Grsliy/mcu-flow-continuity-bernoulli/desain/perakitan-01-dalam-tangki.md

# Perakitan 1 — Dalam Tangki (Langkah 1–8)

Jalur dari pompa sampai tank connector di dinding tangki. Semua di dalam tangki, **PVC 1/2"**. Sketsa tampak atas: `sketsa-atas-tangki.html`.

```
                                   dinding tangki
                     ⑥ siku    ⑦ pipa   │
                       ┌═══════════[SDL]═⑧═ tank connector ──► S1 (langkah 9)
                       │                │
                       │ ⑤ pipa naik    │
                       │                │
 [① POMPA]─[② KATUP]─③─④ siku           │
 ═══════════ dasar tangki ══════════════╧
```

## Langkah

| No | Dari → ke | Barang | Ukuran | Panjang potong | Cara pasang |
|---|---|---|---|---|---|
| 1 | Pompa → katup | **Katup searah kuningan (swing)**, disekrup langsung ke outlet pompa | 1/2" | ± 6 cm (badan katup) | Seal tape 5–6 lilitan, kencangkan dengan tangan. Panah menjauhi pompa, tutup segi enam menghadap atas |
| 2 | Katup → SDL | **SDL** (sok drat luar): ulir ke katup, sisi lem ke pipa | 1/2" | — | Seal tape di ulir SDL, sekrup ke katup |
| 3 | SDL → pipa | **Pipa PVC mendatar** di dasar tangki | 1/2" | ± 6 cm | Lem PVC |
| 4 | Pipa → siku | **Siku 90°**, lubang satunya menghadap **atas** | 1/2" | — | Lem PVC |
| 5 | Siku → pipa | **Pipa PVC tegak** | 1/2" | ± 9 cm | Lem PVC |
| 6 | Pipa → siku | **Siku 90°**, lubang satunya menghadap **dinding** | 1/2" | — | Lem PVC |
| 7 | Siku → pipa | **Pipa PVC mendatar** ke dinding, setinggi ± 12 cm dari dasar | 1/2" | ± 6–10 cm, ukur di tempat | Lem PVC |
| 8 | Pipa → tank connector | **SDL** dilem ke ujung pipa, lalu disekrup ke **tank connector** (drat dalam di kedua sisi) yang menembus dinding | 1/2" | — | Seal karet di sisi dalam tangki, mur dikencangkan dari luar dengan tangan. Seal tape di ulir SDL |

## Belanja

- 1 katup searah kuningan swing 1/2" (bukan tipe pegas)
- 2 SDL 1/2"
- 2 siku 90° 1/2"
- 1 tank connector 1/2", drat dalam di kedua sisi (dengan seal karet dan mur)
- ± 30 cm pipa PVC 1/2"
- Seal tape, lem PVC
- Hole saw sesuai diameter ulir tank connector (± 21–22 mm)

## Catatan

- **Rangkai tanpa lem dulu.** Taruh pompa di dasar tangki, pasang semua bagian, lalu sesuaikan panjang pipa langkah 5 dan 7 sampai ujungnya pas dengan lubang dinding. Baru setelah itu dilem.
- Kalau outlet pompa ternyata **drat dalam**, tambahkan SDL 1/2" di antara pompa dan katup.
- Pipa langkah 3 lewat **di bawah sekat** (sekat tidak sampai dasar, ada celah ± 6 cm).
- Katup searah menahan air di pipa saat pompa mati, sehingga semua kolom manometer tetap terisi (uji nol).
- **Tank connector:** tengah lubang ± 12 cm dari dasar tangki, sejajar pipa langkah 7. Bor pelan dengan hole saw, haluskan tepinya. Seal karet selalu di sisi yang basah (dalam).
- **Urutan kerja:** pasang tank connector dulu → uji bocor (isi air sampai di atas lubang, diamkan beberapa jam) → baru sambungkan rangkaian pipa langkah 1–7.
- Berikutnya — langkah 9: sisi luar tank connector → sensor S1 (YF-S201) langsung disekrup.
