Grsliy/mcu-flow-continuity-bernoulli/catatan/draf-kesepakatan.md

# Kesepakatan Pembuatan Alat Praktikum Fluida Dinamis

*Draf — bagian dalam [kurung siku] diisi sebelum dikirim.*

**Pihak pertama (pembuat):** Guntur Sulistyo
**Pihak kedua (pemesan):** [nama, NIM, program studi]
**Tanggal:** [tanggal]

## 1. Lingkup pekerjaan

Pihak pertama membuat alat praktikum debit, kontinuitas, dan Bernoulli berbasis mikrokontroler, **paket [inti / lengkap]**:

- Paket inti: venturi mendatar + segmen naik, sensor flow, panel manometer, kenop target debit, layar.
- Paket lengkap: paket inti + penyempitan di ketinggian atas dan sensor flow kedua.

**Diserahkan:** alat yang berfungsi, firmware beserta kode sumber, laporan kalibrasi, SOP pemakaian, dan diagram rangkaian.

**Tidak termasuk:** pengambilan data penelitian, analisis data, penulisan skripsi, LKPD, dan instrumen penelitian. Bagian-bagian itu dikerjakan pihak kedua.

## 2. Kriteria alat dinyatakan selesai

1. Debit dapat diatur pada [4–6] L/min dan stabil.
2. Bacaan sensor flow sesuai pengukuran gelas ukur dalam ± [5]%.
3. Selisih kolom venturi sesuai prediksi teori dalam ± [10]% pada 3 debit.
4. Uji nol: saat pompa mati, semua kolom manometer sama tinggi.
5. Tidak ada kebocoran setelah 24 jam terisi air.

## 3. Biaya

| Pos | Jumlah |
|---|---|
| Komponen (sesuai RAB terlampir, dibayar sesuai nota) | ± Rp[...] |
| Jasa | Rp[...] |
| **Total perkiraan** | **Rp[...]** |

Perubahan lingkup setelah kesepakatan ini disepakati tertulis dan dapat menambah biaya.

## 4. Termin

1. Sebelum belanja: dana komponen tahap uji bangku + DP jasa [50]%.
2. Setelah uji bangku lulus: dana komponen sisa.
3. Saat serah terima dan kriteria nomor 2 terpenuhi: pelunasan jasa.

## 5. Jadwal

| Tahap | Target selesai |
|---|---|
| Uji bangku | [tanggal] |
| Perakitan | [tanggal] |
| Kalibrasi & serah terima | [tanggal] |

## 6. Garansi

Perbaikan tanpa biaya jasa selama [1 bulan] setelah serah terima untuk kerusakan akibat perakitan. Komponen yang rusak karena pemakaian diganti dengan biaya pihak kedua.

## 7. Lain-lain

- Pihak kedua bebas memakai alat dan data yang dihasilkan untuk skripsi dan publikasi.
- [Opsional] Pihak pertama boleh membuat ulang desain alat ini untuk pihak lain.

| Pihak pertama | Pihak kedua |
|---|---|
| <br><br>Guntur Sulistyo | <br><br>[nama] |

*Lampiran: RAB (`anggaran/RAB-alat-praktikum-rev08.xlsx`).*
