Grsliy/mcu-flow-continuity-bernoulli/desain/perhitungan/01-pipa-dan-debit.md

# 1 — Pipa & Rentang Debit

Rev. 08. Hitungan ideal (tanpa rugi), g = 9,81 m/s².

| Bagian | Diameter dalam | Luas | Rasio |
|---|---|---|---|
| Pipa besar (S1, zona A, B) | 19 mm | 2,84 cm² | 1 |
| Leher venturi | 10 mm | 0,79 cm² | 3,61 |
| Zona C (opsional) | 13 mm | 1,33 cm² | 2,14 |

⚠️ Diameter mengasumsikan tabung akrilik tebal 3 mm. Ukur diameter riil, lalu hitung ulang.

v = Q/A · Δh = (v₂² − v₁²) / 2g

| Debit | v pipa besar | v leher | v zona C | Δh 1↔2 | Δh 5↔6 | Re |
|---|---|---|---|---|---|---|
| 2 L/min | 0,12 m/s | 0,42 m/s | 0,25 m/s | 8 mm | 3 mm | 2.200 |
| 3 L/min | 0,18 m/s | 0,64 m/s | 0,38 m/s | 19 mm | 6 mm | 3.300 |
| 4 L/min | 0,24 m/s | 0,85 m/s | 0,50 m/s | 34 mm | 10 mm | 4.500 |
| 5 L/min | 0,29 m/s | 1,06 m/s | 0,63 m/s | 53 mm | 16 mm | 5.600 |
| 6 L/min | 0,35 m/s | 1,27 m/s | 0,75 m/s | 76 mm | 23 mm | 6.700 |

**Batas**
- Atas 6 L/min: rentang S2 (YF-S401).
- Bawah: di bawah 4 L/min aliran masih transisi (Re < 4.000); di bawah 3 L/min selisih kolom terlalu kecil untuk dibaca.
- Zona C: selisih hanya 6–10 mm di 3–4 L/min.
- S1 bekerja di ujung bawah rentangnya → wajib kalibrasi.

**Kesimpulan:** debit kerja 4–6 L/min, titik data 4,0 / 4,5 / 5,0 / 5,5 / 6,0 L/min. Zona A = data utama.
