Grsliy/mcu-flow-continuity-bernoulli/arsip/README.md

# Arsip

Materi desain yang **sudah tidak berlaku**, disimpan sebagai jejak keputusan. Jangan dipakai sebagai acuan kerja — acuan aktif ada di `catatan/konteks-dan-spesifikasi.md` dan `desain/`.

| File | Isi | Kenapa diarsipkan |
|---|---|---|
| `draft-desain-awal.md` | Draft desain paling awal | Digantikan catatan spesifikasi |
| `gravity-fed/sketsa-sistem.html` | Diagram blok + tampak samping awal | Arsitektur gravity-fed dibatalkan di Rev. 07 |
| `gravity-fed/peta-eksperimen.html` | Peta "apa dibuktikan di mana" | Masih memakai tangki sumber & mode Isi/Tahan/Mati |
| `gravity-fed/perhitungan-dimensi-rev06.html` | Hitungan dimensi Rev. 06 | Dasar hitungannya tinggi tangki, bukan pompa |
| `gravity-fed/estimasi-budget-rev06.html` | Estimasi budget Rev. 06 (Rp3,0–5,4 jt, opsi A–H) | Komponen berubah (rak & tangki kedua hilang, pompa diganti DC) |

File HTML bisa dibuka langsung di browser.
