Grsliy/mcu-flow-continuity-bernoulli/anggaran/RAB-alat-praktikum-rev08.xlsx

Sheet: RAB
RENCANA ANGGARAN BIAYA — Alat Praktikum Fluida Dinamis (Debit, Kontinuitas, Bernoulli)
Desain: Rev. 08 — satu tangki, pompa langsung, leher angsa, tanpa servo. Paket inti = zona A + B.
Harga perkiraan = kisaran marketplace Indonesia, belum diverifikasi. Kolom kuning diisi setelah riset; total, subtotal, dan ringkasan terhitung otomatis. Total Dipakai memakai harga online bila sudah diisi.
No | Nama Barang | Spesifikasi | Fungsi | Paket | Satuan | Jumlah | Harga Perkiraan (Rp/satuan) | Total Perkiraan (Rp) | Harga Online Shop (Rp/satuan) | Total Online (Rp) | Total Dipakai (Rp) | Selisih (Online − Perkiraan) | Toko / Link | Status | Catatan
A. ELEKTRONIK
1 | ESP32-C3 Super Mini | RISC-V 160 MHz, WiFi/BLE, USB-C, logika 3,3 V | Otak alat: baca S1, kontrol PI pompa, layar, tombol, log data | Inti | pcs | 2 | Rp 40000 |  | Rp 35000 |  |  |  |  | Dipesan | Baru dibeli 1, cadangan belum. Pin tidak tahan 5 V; jangan pakai GPIO 2/8/9 untuk kendali pompa
2 | LCD 20×4 + modul I2C | 20×4 karakter, backlight | Tampil debit, kecepatan, prediksi, pesan error | Inti | pcs | 1 | Rp 75000 |  | Rp 150000 |  |  |  |  | Belum
3 | Sensor flow YF-S201 (S1) | Ulir G1/2", 1–30 L/min, hall-effect | Debit utama | Inti | pcs | 1 | Rp 35000 |  | Rp 29189 |  |  |  |  | Diterima | Wajib dikalibrasi volumetrik
4 | Sensor flow YF-S201 (cadangan) | Sama dengan S1 | Suku cadang bila S1 rusak saat pengambilan data | Inti | pcs | 1 | Rp 35000 |  |  |  |  |  |  | Belum | Bisa dicoret kalau budget ketat
5 | Pompa celup DC 12 V | Brushless 12 V, 22 W, 800 L/jam, drat in/out 1/2" | Mendorong aliran | Inti | pcs | 1 | Rp 120000 |  | Rp 97038 |  |  |  | https://shopee.co.id/MAXPUMP-Pompa-Celup-Air-Bersih-DC-12V-24V-Submersible-Pump-Pompa-Kolam-Ikan-Brushless-5m-Aquarium-Hidroponik-i.17799491.12107841427 | Dipesan | Cek: celup atau inline. Uji ember: tegangan minimum & 4–6 L/min stabil
6 | MOSFET gate 3,3 V | AO3400 / IRLML6244 (atau modul + transistor pendorong), ≥ 3 A | Saklar PWM pompa / kendali buck | Inti | pcs | 2 | Rp 7500 |  |  |  |  |  |  | Belum | Pull-down 10 kΩ di gate → pompa mati saat reset/upload
7 | Modul buck DC-DC 5 A (pompa) | XL4015 / setara, tegangan keluaran bisa diatur | Atur kecepatan pompa lewat tegangan (pompa brushless tanpa kabel PWM) | Inti | pcs | 1 | Rp 30000 |  |  |  |  |  |  | Belum | Cara kendali dari MCU ditentukan saat uji bangku
8 | Level shifter 4 kanal | BSS138, 3,3 V ↔ 5 V | Sinyal YF-S201 & I2C LCD ke ESP32-C3 | Inti | pcs | 1 | Rp 8000 |  |  |  |  |  |  | Belum
9 | Modul step-down 12 V → 5 V | LM2596 / Mini-360 | Catu daya MCU & LCD | Inti | pcs | 1 | Rp 12000 |  | Rp 0 |  |  |  |  | Belum
10 | Adaptor 12 V 5 A | Switching, casing tertutup | Sumber daya utama | Inti | pcs | 1 | Rp 70000 |  | Rp 0 |  |  |  |  | Belum | Letakkan jauh dari air
11 | Sekring + holder inline | 3–5 A | Proteksi hubung singkat | Inti | set | 1 | Rp 8000 |  |  |  |  |  |  | Belum
12 | Saklar daya (rocker) | 6 A | ON/OFF alat | Inti | pcs | 1 | Rp 5000 |  |  |  |  |  |  | Belum
13 | Jack DC panel female | 5,5 × 2,1 mm | Input adaptor | Inti | pcs | 1 | Rp 5000 |  |  |  |  |  |  | Belum
14 | Potensiometer 10 kΩ + knob | Linear, dudukan panel | Kenop target debit | Inti | pcs | 1 | Rp 10000 |  |  |  |  |  |  | Belum
15 | Tombol tekan panel | 12 mm, momentary | Tombol CEK + Start/Stop | Inti | pcs | 2 | Rp 5000 |  |  |  |  |  |  | Belum
16 | Buzzer aktif 5 V |  | Sonifikasi debit & alarm | Inti | pcs | 1 | Rp 5000 |  |  |  |  |  |  | Belum
17 | Komponen pasif | Resistor 10 kΩ & 4,7 kΩ, kapasitor filter, dioda flyback 1N5819 | Pull-down gate, pull-up & filter sensor, proteksi pompa | Inti | paket | 1 | Rp 15000 |  | Rp 0 |  |  |  |  | Belum
18 | PCB lubang + header + terminal sekrup | ± 7 × 9 cm | Papan rangkaian | Inti | set | 1 | Rp 20000 |  |  |  |  |  |  | Belum
19 | Kabel & heatshrink | Kabel serabut, jumper, kabel sensor berpelindung ± 5 m | Pengkabelan; jalur sensor dipisah dari kabel pompa | Inti | paket | 1 | Rp 35000 |  |  |  |  |  |  | Belum | Kabel berpelindung mengurangi pulsa palsu dari derau motor
20 | Kotak elektronik tahan cipratan | Junction box IP65 ± 15 × 10 × 7 cm | Elektronik di atas garis air | Inti | pcs | 1 | Rp 45000 |  |  |  |  |  |  | Belum
21 | Sensor flow YF-S401 (S2) | 0,3–6 L/min | Sensor kedua di zona C | Lengkap | pcs | 1 | Rp 45000 |  | Rp 42211 |  |  |  |  | Diterima | Uji rugi tekanan dulu: harus ≤ ± 90 mm di 6 L/min
22 | Stop kontak / adaptor ber-RCD | Portable RCD 30 mA | Keselamatan listrik dekat air | Opsional | pcs | 1 | Rp 200000 |  |  |  |  |  |  | Belum | Tidak perlu jika stop kontak lab sudah ber-RCD
23 | Sensor tekanan analog 0–10 kPa | MPX5010DP / XGZP6847 | Demo hidrostatis tangki | Opsional | pcs | 1 | Rp 120000 |  |  |  |  |  |  | Belum | Hanya jika hidrostatis masuk materi skripsi
24 | Sensor ultrasonik HC-SR04 |  | Tinggi air tangki (demo hidrostatis) | Opsional | pcs | 1 | Rp 15000 |  |  |  |  |  |  | Belum | Pasangan sensor tekanan di atas
 | Subtotal Elektronik — paket inti
B. MEKANIS — HIDROLIK (pipa, aliran, manometer)
25 | Tangki akrilik custom + tutup | ± 30 × 20 × 25 cm, tebal 4–5 mm | Tangki air tunggal | Inti | pcs | 1 | Rp 220000 |  |  |  |  |  |  | Belum | Alternatif hemat: kontainer plastik bening ± Rp60 rb. Uji bangku pakai ember
26 | Sekat tangki | Potongan akrilik | Pisahkan air balik dari hisapan pompa | Inti | pcs | 1 | Rp 15000 |  |  |  |  |  |  | Belum
27 | Saringan hisapan pompa | Spons / kasa halus | Cegah serpihan menyumbat S1 & sadap | Inti | pcs | 1 | Rp 10000 |  |  |  |  |  |  | Belum
28 | Tabung akrilik OD 25 / ID 19 mm | Panjang 1 m per batang | Pipa uji: sebelum venturi & tanjakan | Inti | batang | 2 | Rp 75000 |  |  |  |  |  |  | Belum | Ukur ID riil dengan jangka sorong sebelum cetak venturi
29 | Venturi cetak 3D PETG | ID 19 → leher 10 → 19, nipple sadap menyatu | Zona A (bukti utama) | Inti | pcs | 3 | Rp 50000 |  |  |  |  |  |  | Belum | Cetak 3, pakai yang lehernya paling presisi (Δh ∝ d⁻⁴)
30 | Katup searah swing/flapper 3/4" | Tekanan buka rendah (bukan tipe pegas) | Tahan air saat pompa mati → uji nol | Inti | pcs | 1 | Rp 50000 |  |  |  |  |  |  | Belum | Uji bangku: tahan kolom 170 mm ≥ 10 menit
31 | Ball valve PVC 3/4" |  | Penyetelan & perawatan (bukan kenop siswa) | Inti | pcs | 1 | Rp 15000 |  |  |  |  |  |  | Belum
32 | Pipa PVC 3/4" AW | 1 batang 4 m | Leher angsa, pipa balik, pipa limpah | Inti | batang | 1 | Rp 45000 |  |  |  |  |  |  | Belum
33 | Fitting PVC 3/4" | Elbow, tee, sok drat (± 10 pcs) | Sambungan pipa | Inti | paket | 1 | Rp 50000 |  |  |  |  |  |  | Belum
34 | Sok reduksi 3/4" ↔ 1/2" | Ulir dalam 1/2" | Sambung S1 (2) & outlet pompa 1/2" (1) | Inti | pcs | 3 | Rp 8000 |  |  |  |  |  |  | Belum
35 | Sambungan akrilik ↔ PVC | Rubber coupling / sok OD 25 mm | Transisi tabung akrilik ke fitting PVC | Inti | pcs | 4 | Rp 12000 |  |  |  |  |  |  | Belum
36 | Tank connector (bulkhead) 3/4" | Dengan seal karet | Keluaran pompa & masuk air balik | Inti | pcs | 2 | Rp 20000 |  |  |  |  |  |  | Belum | Air balik masuk dari atas, jauh dari pompa
37 | Corong plastik | Ø ± 8 cm | Penampung air jatuh dari leher angsa (anti sifon) | Inti | pcs | 1 | Rp 8000 |  |  |  |  |  |  | Belum
38 | Keran kuras 1/2" |  | Pengurasan tangki (cegah lumut & jentik) | Inti | pcs | 1 | Rp 15000 |  |  |  |  |  |  | Belum
39 | Tabung manometer bening | Akrilik OD 10 / ID 7 mm, 40 cm — satu batch, ID sama | Kolom manometer 1–5 | Inti | pcs | 5 | Rp 15000 |  |  |  |  |  |  | Belum | ID harus identik: beda kapilaritas masuk ke Δh
40 | Selang bening ID 6 mm | Silikon / PVC | Sadap → tabung, pipa limpah panel | Inti | m | 6 | Rp 5000 |  |  |  |  |  |  | Belum
41 | Nipple kuningan barb 6 mm | Ulir M5 / 1/8" | Titik sadap di tabung akrilik (sadap 1, 3, 4, 5) | Inti | pcs | 4 | Rp 8000 |  | Rp 30000 |  |  |  |  | Belum | Sadap 2 sudah menyatu dengan venturi
42 | Klem penjepit selang | Pinch clamp | Buang udara per selang | Inti | pcs | 5 | Rp 3000 |  |  |  |  |  |  | Belum
43 | Peredam kolom | Jarum tumpul 18–20 G / pipa kapiler | Redam getaran kolom akibat pompa | Inti | pcs | 5 | Rp 3000 |  |  |  |  |  |  | Belum
44 | Manifold limpah manometer | Talang di atas tabung + selang ke tangki | Air yang meluap kembali ke tangki, tidak ke elektronik | Inti | set | 1 | Rp 25000 |  |  |  |  |  |  | Belum
45 | Tabung akrilik OD 19 / ID 13 mm | 1 m | Pipa zona C | Lengkap | batang | 1 | Rp 60000 |  |  |  |  |  |  | Belum
46 | Reducer 19 → 13 mm (cetak 3D) | Dengan nipple sadap 6 | Penyempitan zona C | Lengkap | pcs | 1 | Rp 30000 |  |  |  |  |  |  | Belum
47 | Tabung manometer ke-6 | Sama dengan tabung 1–5 | Kolom zona C / tabung pitot | Lengkap | pcs | 1 | Rp 15000 |  |  |  |  |  |  | Belum | Bisa juga untuk opsi pitot di paket inti
48 | Jarum stainless (tabung pitot) | Ø ± 1,2 mm, dibengkokkan menghadap arus | Baca energi total di leher venturi | Opsional | pcs | 1 | Rp 10000 |  |  |  |  |  |  | Belum
 | Subtotal Mekanis — Hidrolik — paket inti
C. MEKANIS — STRUKTUR & PANEL
49 | Pelat dasar | Multipleks 18 mm atau akrilik, ± 100 × 35 cm | Alas seluruh alat | Inti | pcs | 1 | Rp 90000 |  |  |  |  |  |  | Belum
50 | Rangka tegak | Hollow aluminium 20 × 20 mm (atau kayu) | Penyangga pipa & panel | Inti | m | 3 | Rp 35000 |  |  |  |  |  |  | Belum
51 | Papan panel manometer | PVC board / akrilik putih ± 45 × 40 cm | Latar tabung & skala | Inti | pcs | 1 | Rp 50000 |  |  |  |  |  |  | Belum
52 | Cetak stiker skala & peta pipa | Vinyl: skala 0–350 mm, garis merah z, skala kedua, kode warna | Skala baca & petunjuk untuk siswa | Inti | lembar | 1 | Rp 30000 |  |  |  |  |  |  | Belum
53 | Klem pipa (saddle / U-clamp) | 3/4" & 25 mm | Tahan pipa ke rangka | Inti | pcs | 10 | Rp 2500 |  |  |  |  |  |  | Belum
54 | Klip tabung manometer | Clip 10 mm | Tahan tabung di panel | Inti | pcs | 10 | Rp 1500 |  |  |  |  |  |  | Belum
55 | Baut, mur, sekrup, siku | Paket campur | Perakitan rangka & panel | Inti | paket | 1 | Rp 35000 |  |  |  |  |  |  | Belum
56 | Kaki karet |  | Stabil & anti gores | Inti | pcs | 4 | Rp 3000 |  |  |  |  |  |  | Belum
 | Subtotal Mekanis — Struktur & Panel — paket inti
D. BAHAN HABIS PAKAI
57 | Lem PVC |  | Sambungan PVC | Inti | pcs | 1 | Rp 15000 |  |  |  |  |  |  | Belum
58 | Lem akrilik (solvent) |  | Sambungan akrilik | Inti | pcs | 1 | Rp 20000 |  |  |  |  |  |  | Belum
59 | Sealant silikon akuarium | Tabung ± 300 mL | Kedap air sambungan & bulkhead | Inti | pcs | 1 | Rp 35000 |  |  |  |  |  |  | Belum
60 | Seal tape |  | Sambungan ulir | Inti | roll | 2 | Rp 3000 |  |  |  |  |  |  | Belum
61 | Pewarna makanan | Warna gelap | Kontras kolom manometer | Inti | botol | 1 | Rp 5000 |  |  |  |  |  |  | Belum | Jangan disuntik untuk visual aliran (seluruh tangki ikut berwarna)
62 | Amplas & perlengkapan finishing |  | Merapikan hasil cetak & potongan | Inti | paket | 1 | Rp 15000 |  |  |  |  |  |  | Belum
 | Subtotal Bahan Habis Pakai — paket inti
E. ALAT BANTU & KALIBRASI (isi jumlah 0 jika sudah punya)
63 | Jangka sorong digital | 0–150 mm, resolusi 0,01 mm | Ukur ID pipa & leher venturi | Inti | pcs | 1 | Rp 80000 |  |  |  |  |  |  | Belum | Isi jumlah 0 kalau sudah punya
64 | Mata bor 9,5 / 10 / 10,5 mm | Dipakai sebagai batang ukur | Cek diameter leher venturi | Inti | set | 1 | Rp 30000 |  |  |  |  |  |  | Belum | Pengganti pin gauge yang mahal
65 | Gelas ukur 2 L | Skala 50 mL | Kalibrasi volumetrik S1 | Inti | pcs | 1 | Rp 35000 |  |  |  |  |  |  | Belum | Stopwatch pakai HP
66 | Ember 15–20 L |  | Tangki sementara uji bangku | Inti | pcs | 1 | Rp 25000 |  |  |  |  |  |  | Belum
67 | Waterpass / selang air |  | Sejajarkan datum & angka 0 skala | Inti | pcs | 1 | Rp 25000 |  |  |  |  |  |  | Belum
 | Subtotal Alat Bantu & Kalibrasi — paket inti
F. BIAYA LAIN
68 | Ongkos kirim | Perkiraan beberapa toko |  | Inti | paket | 1 | Rp 100000 |  |  |  |  |  |  | Belum | Sesuaikan setelah checkout
69 | Transport belanja lokal | Toko bangunan, akrilik, elektronik |  | Inti | paket | 1 | Rp 50000 |  |  |  |  |  |  | Belum
 | Subtotal Biaya Lain — paket inti
G. JASA
70 | Desain & perhitungan | Rev. 01–08, profil manometer, sketsa |  | Inti | paket | 1 | Rp 250000 |  |  |  |  |  |  | Belum
71 | Uji bangku & penyesuaian | Pompa, S1, katup searah, venturi |  | Inti | paket | 1 | Rp 150000 |  |  |  |  |  |  | Belum
72 | Perakitan mekanik & hidrolik | Pipa, venturi, panel manometer, uji bocor 24 jam |  | Inti | paket | 1 | Rp 400000 |  |  |  |  |  |  | Belum
73 | Elektronik & firmware | Kontrol PI, ukur periode pulsa, pengaman luapan, LCD, tombol CEK, log serial |  | Inti | paket | 1 | Rp 450000 |  |  |  |  |  |  | Belum
74 | Kalibrasi & laporan kalibrasi | Kalibrasi volumetrik S1, uji nol, ukur leher venturi |  | Inti | paket | 1 | Rp 150000 |  |  |  |  |  |  | Belum
75 | Dokumentasi | SOP, manual alat, diagram rangkaian |  | Inti | paket | 1 | Rp 100000 |  |  |  |  |  |  | Belum | Bukan LKPD/instrumen penelitian (itu isi skripsi client)
76 | Jasa tambahan paket lengkap | Zona C + S2 + uji rugi tekanan S2 |  | Lengkap | paket | 1 | Rp 200000 |  |  |  |  |  |  | Belum
 | Subtotal Jasa — paket inti

Sheet: Keuangan
KEUANGAN PROYEK — dana masuk, pengeluaran, sisa
Sel kuning diisi. Simpan foto nota di folder anggaran/nota/ lalu tulis nama filenya di kolom File nota; kolom Link otomatis membukanya.
Buka folder nota
RINGKASAN
Dana diterima
Sudah dipakai
Sisa dana
1. DANA MASUK
Tanggal | Keterangan |  | Jumlah |  |  | File nota / bukti | Link | Catatan
 | DP dari client |  | Rp 1000000 |  |  |  | nota/ | Isi tanggal transfer
 |  |  |  |  |  |  | nota/
 |  |  |  |  |  |  | nota/
 |  |  |  |  |  |  | nota/
 |  |  |  |  |  |  | nota/
 |  |  |  |  |  |  | nota/
 | Total dana masuk
2. PENGELUARAN
Tanggal | Barang / keperluan | Jumlah | Harga satuan | Total | Toko | File nota | Link | Catatan
 | Sensor flow YF-S401 (S2) | 1 | Rp 42211 |  |  |  | nota/ | Untuk uji rugi tekanan zona C
 | Sensor flow YF-S201 (S1) | 1 | Rp 29189 |  |  |  | nota/
 | Pompa DC brushless 12 V 22 W 800 L/jam | 1 | Rp 97038 |  |  |  | nota/
 | ESP32-C3 Super Mini | 1 | Rp 35000 |  |  |  | nota/
 |  |  |  |  |  |  | nota/
 |  |  |  |  |  |  | nota/
 |  |  |  |  |  |  | nota/
 |  |  |  |  |  |  | nota/
 |  |  |  |  |  |  | nota/
 |  |  |  |  |  |  | nota/
 |  |  |  |  |  |  | nota/
 |  |  |  |  |  |  | nota/
 |  |  |  |  |  |  | nota/
 |  |  |  |  |  |  | nota/
 |  |  |  |  |  |  | nota/
 |  |  |  |  |  |  | nota/
 |  |  |  |  |  |  | nota/
 |  |  |  |  |  |  | nota/
 |  |  |  |  |  |  | nota/
 |  |  |  |  |  |  | nota/
 |  |  |  |  |  |  | nota/
 |  |  |  |  |  |  | nota/
 |  |  |  |  |  |  | nota/
 |  |  |  |  |  |  | nota/
 |  |  |  |  |  |  | nota/
 |  |  |  |  |  |  | nota/
 |  |  |  |  |  |  | nota/
 |  |  |  |  |  |  | nota/
 |  |  |  |  |  |  | nota/
 |  |  |  |  |  |  | nota/
 |  |  |  |  |  |  | nota/
 |  |  |  |  |  |  | nota/
 |  |  |  |  |  |  | nota/
 |  |  |  |  |  |  | nota/
 |  |  |  |  |  |  | nota/
 |  |  |  |  |  |  | nota/
 |  |  |  |  |  |  | nota/
 |  |  |  |  |  |  | nota/
 |  |  |  |  |  |  | nota/
 |  |  |  |  |  |  | nota/
 | Total pengeluaran

Sheet: Ringkasan
RINGKASAN RAB — Rev. 08
Semua angka dihitung dari sheet RAB. Sel kuning boleh diubah.
Target budget total (komponen + jasa) | Rp 2000000
Kontingensi (cadangan harga naik / salah beli) | 10%
1. PAKET INTI (zona A + B)
Pos | Perkiraan | Online (yang sudah diisi) | Dipakai | Harga online terisi
Elektronik
Mekanis — Hidrolik
Mekanis — Struktur & Panel
Bahan Habis Pakai
Alat Bantu & Kalibrasi
Subtotal komponen
Kontingensi |  |  |  | Subtotal komponen × persentase di B5
Biaya lain (ongkir, transport)
Total biaya barang
Jasa
TOTAL PAKET INTI
Selisih terhadap target (+ = melebihi)
Status
Porsi jasa dari total
2. PAKET LENGKAP & OPSIONAL
Pos | Perkiraan | Online (yang sudah diisi) | Dipakai | Keterangan
Tambahan paket lengkap (zona C + S2) |  |  |  | Barang + jasa tambahan, kontingensi hanya untuk barang
TOTAL PAKET LENGKAP |  |  |  | Syarat: YF-S401 lolos uji rugi tekanan
Item opsional (tidak masuk total) |  |  |  | RCD, demo hidrostatis, tabung pitot — ditambahkan terpisah bila dipilih

Sheet: Petunjuk
CARA MEMAKAI RAB
1. Isi kolom kuning di sheet RAB setelah riset: Harga Online Shop (per satuan), Toko / Link, dan Status.
2. Total Online, Total Dipakai, Selisih, subtotal, dan sheet Ringkasan terhitung otomatis.
3. Total Dipakai = harga online jika sudah diisi, jika belum memakai harga perkiraan. Ringkasan memakai angka ini.
4. Barang yang sudah dimiliki (mis. jangka sorong): ubah Jumlah jadi 0, jangan hapus barisnya.
5. Kolom Paket: Inti = masuk total paket inti; Lengkap = hanya paket lengkap; Opsional = tidak masuk total.
6. Target budget dan persentase kontingensi bisa diubah di sheet Ringkasan (sel kuning B4 dan B5).
7. Menambah barang: sisipkan baris di dalam kelompoknya (di atas baris Subtotal) lalu salin rumus kolom I, K, L, M dari baris di atasnya.
CATATAN
• Harga perkiraan adalah kisaran marketplace, bukan harga pasti. Verifikasi sebelum dikirim ke client.
• Jangan belanja penuh sebelum kesepakatan tertulis dan DP.
• Ukuran pipa (ID 19 / 10 / 13 mm) masih asumsi tabung akrilik tebal 3 mm; ukur ID riil sebelum mencetak venturi.
• Jasa dokumentasi = SOP, manual alat, diagram rangkaian. LKPD dan instrumen penelitian adalah isi skripsi client, bukan bagian RAB ini.
• Acuan desain: catatan/konteks-dan-spesifikasi.md dan desain/perhitungan/.
KEUANGAN
• Sheet Keuangan: catat setiap dana masuk dan setiap pembelian. Sisa dana dihitung otomatis.
• Nota disimpan di folder anggaran/nota/ dengan nama TANGGAL_barang.jpg; tulis nama file di kolom File nota.
• Setelah membeli, isi juga harga beli dan status 'Diterima' di sheet RAB supaya total RAB memakai harga nyata.
