Grsliy/mcu-flow-continuity-bernoulli/(list of files, cad)

Other CAD files:
desain/cad/gambar-2d.dxf
