Grsliy/mcu-flow-continuity-bernoulli/(commit log)

2026-09-20 Tambah catatan konteks & spesifikasi project
    Rangkum scope kerja, model bisnis, dan arah desain teknis yang
    berkembang lewat diskusi dengan client: kontrol pompa (isi-ulang
    ketinggian), servo valve, sensor ketinggian untuk tekanan hidrostatis
    (P=rho*g*h), dan fitur presentasi/engagement. Termasuk estimasi biaya
    berjalan dan pertanyaan yang masih menggantung ke client.
2026-09-20 Rombak catatan: manometer bank, peran pompa, syarat pembuktian
    Perubahan utama setelah diskusi desain lanjutan:
    - Tambah Fitur #5 (panel manometer 6 tabung) — tekanan jadi terukur
    langsung, bukan dihitung; hitungan Bernoulli berubah peran jadi
    pembanding teori vs pengukuran.
    - Perjelas peran pompa jadi tiga mode (Isi/Tahan/Mati). Mode Tahan =
    constant head tank elektronik. Rencana pompa kedua dibatalkan karena
    kontrol debit sudah dipegang katup servo.
    - Koreksi desain: S1 dan S2 harus di penampang berbeda (tambah reducer
    sebelum S2) — versi sebelumnya keliru menaruh keduanya di pipa sama.
    - Arsitektur fisik final: hybrid benchtop, tangki di rak pendek.
    - Tambah sub-bab syarat a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
2026-09-27 Ganti arsitektur ke pompa langsung satu tangki (Rev. 07)
    Gravity-fed dibatalkan: rak, tangki kedua, dan mode Isi/Tahan/Mati
    dihapus. Pompa DC PWM mengatur debit, katup hilir servo mengatur
    level kolom manometer. P = rho g h hidrostatis jadi demo terpisah
    opsional, menunggu konfirmasi materi dari client.
2026-09-27 Rev. 08: hapus servo, leher angsa, profil manometer
    - Servo katup dihapus, diganti leher angsa (level kolom otomatis,
    tekanan sadap selalu positif) dan ball valve manual
    - Kenop jadi target debit dengan kontrol PI, pengaman luapan di firmware
    - Paket inti zona A+B; zona C + S2 opsional dengan syarat rugi S2
    <= 90 mm di 6 L/min
    - Tambah katup searah, kalibrasi volumetrik S1, uji nol, garis z dan
    skala kedua di panel manometer
    - Perhitungan 02 (profil manometer) dan koreksi Bagian 1: debit kerja
    utama 4-6 L/min, Re 3.300 masih transisi, C_d hanya perkiraan
    - Sketsa Rev. 08 dan pertanyaan ke client diperbarui
2026-09-27 Tambah RAB paket inti dan lengkap (Rev. 08)
    - anggaran/RAB-alat-praktikum-rev08.xlsx: 74 barang dikelompokkan
    (elektronik, mekanis hidrolik, struktur & panel, bahan habis pakai,
    alat bantu, biaya lain, jasa) dengan harga perkiraan, kolom harga
    online shop untuk diisi setelah riset, dan ringkasan otomatis
    - Perkiraan awal paket inti +- Rp4,1 juta, di atas target Rp2 juta
    - README dan catatan menunjuk ke file RAB
    [RAB-alat-praktikum-rev08.xlsx]
2026-09-27 Ringkas README, catatan spesifikasi, dan perhitungan
    Isi keputusan, angka hitungan, syarat data valid, pertanyaan ke client,
    dan log keputusan tetap; penjelasan panjang, riwayat desain di README,
    tabel biaya lama, dan daftar komponen (sudah ada di RAB) dibuang.
2026-09-29 Isi awal RAB: link pompa MAXPUMP, harga Nano dan adaptor 0
    [RAB-alat-praktikum-rev08.xlsx]
2026-10-01 Isi RAB: harga LCD dan nipple, step-down & komponen pasif 0, catatan ganti ESP32-C3 Mini
    [RAB-alat-praktikum-rev08.xlsx]
2026-10-04 RAB: spesifikasi pompa MAXPUMP 19 W dan sok reduksi untuk outlet 1/2"
    [RAB-alat-praktikum-rev08.xlsx]
2026-10-04 RAB: ganti MCU ke ESP32-C3 Super Mini, tambah level shifter, MOSFET 3,3 V, dan buck pompa
    [RAB-alat-praktikum-rev08.xlsx]
2026-10-04 Tambah rencana firmware dan pinout ESP32-C3
2026-10-04 Sketsa: air balik di atas muka air dengan sekat, talang limpah manometer
2026-10-11 Tambah jadwal harian, sheet keuangan, folder nota, dan harga beli sensor
2026-10-26 Tambah sketsa tampak atas bagian dalam tangki (pompa sampai tank connector)
2026-10-28 README: tambah langkah perakitan dan folder cad di daftar folder
2026-10-28 Spesifikasi: catat pompa 22 W di riwayat revisi
2026-10-28 Perhitungan pompa: katup searah langsung di outlet 1/2"
2026-10-28 Jadwal harian: perbarui nama pompa di hari 1
2026-10-28 RAB: catat harga beli pompa 22 W dan ESP32-C3
2026-10-28 Tambah langkah perakitan 1–8 (dalam tangki)
2026-10-28 Tambah langkah perakitan 9–20 (luar tangki)
2026-10-28 Tambah model CAD venturi (OpenSCAD, parametrik)
2026-10-28 Tambah model CAD 3D alat lengkap
2026-10-28 Tambah pratinjau CAD tampak depan dan atas
2026-10-28 CAD: geser mulut leher angsa 20 mm agar corong tidak menabrak pipa naik
2026-10-28 Pratinjau CAD: perbarui posisi mulut leher angsa
2026-10-28 Perakitan langkah 19: pipa puncak leher angsa jadi ± 8 cm
2026-10-28 README: sebut gambar kerja 2D di folder cad
